maallyn/mechanical_tv_exhibit/tv_doc/bottom_of_chassis.jpg

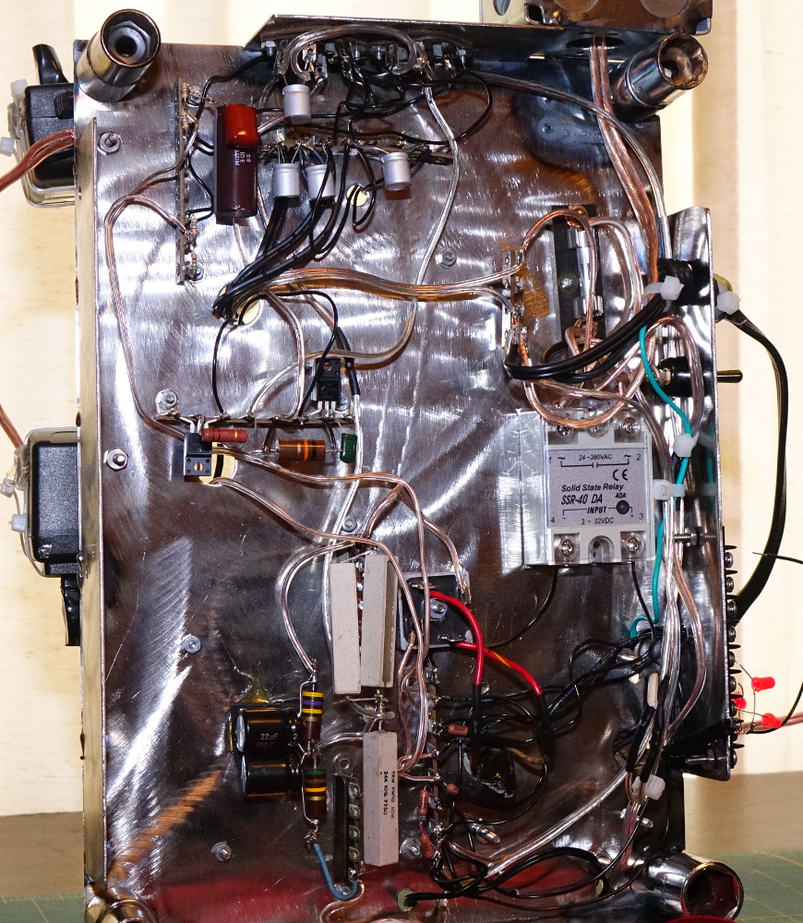
tv_doc/bottom_of_chassis.jpg
