maallyn/mechanical_tv_exhibit/tv_doc/front_of_chassis.jpg

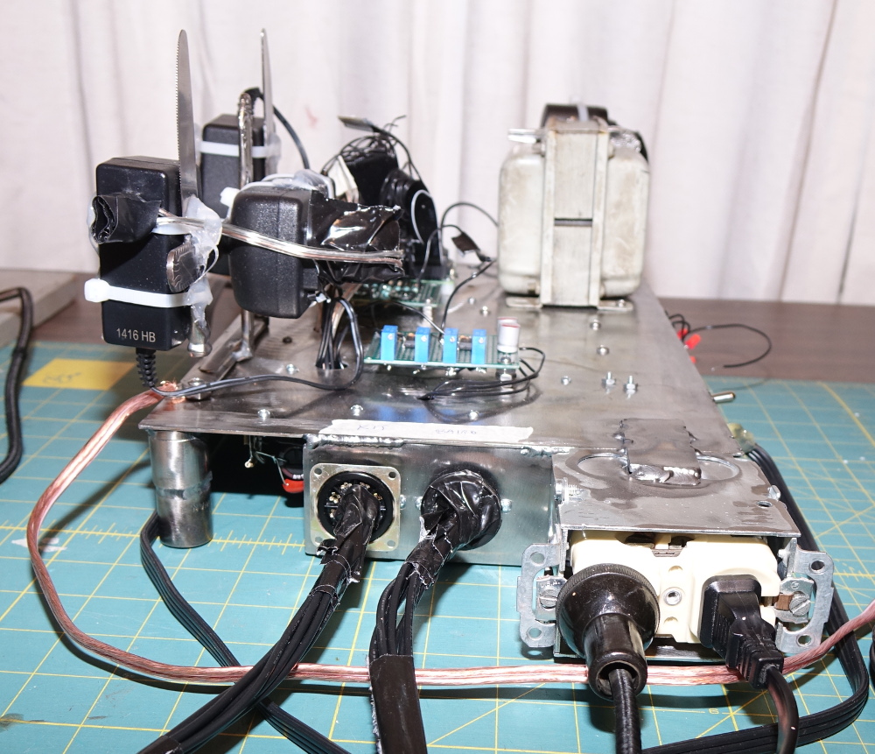
tv_doc/front_of_chassis.jpg
