maallyn/mechanical_tv_exhibit/README.md

# mechanical_tv_exhibit
This is software that is run on a Raspberry pi that is used to send signals
to two vintage mechanic televisions at the Sparc Museum in Bellingham,
Washington.
